HarshitJazz123/VibeSense/docs/images/dashboard pic 1.png

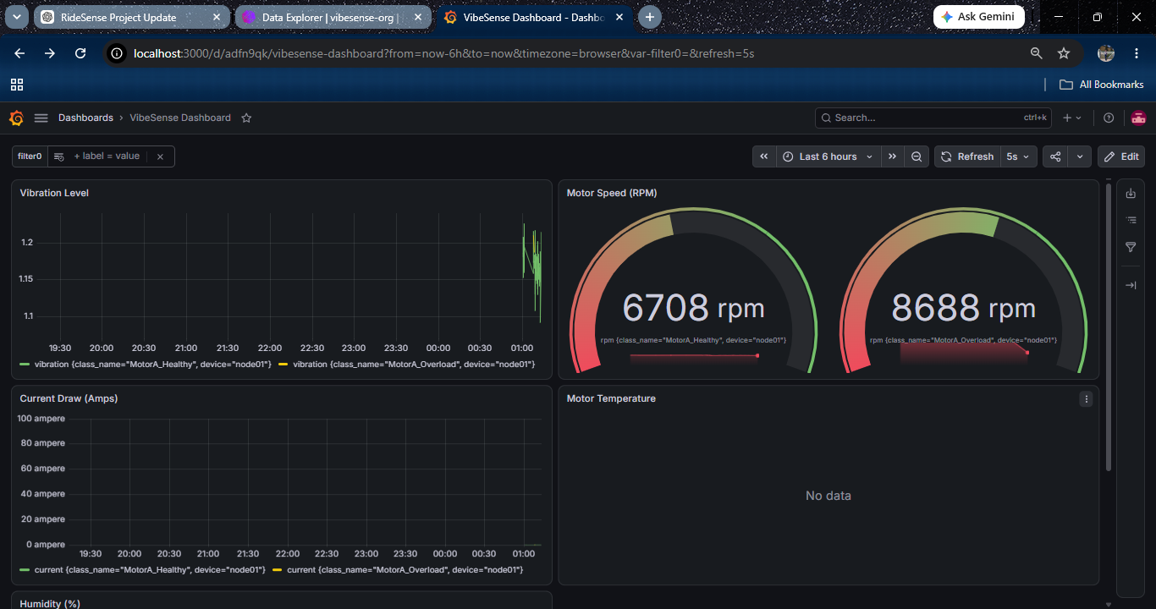
docs/images/dashboard pic 1.png
