HarshitJazz123/VibeSense/docs/images/dashboard pic 3.jpeg

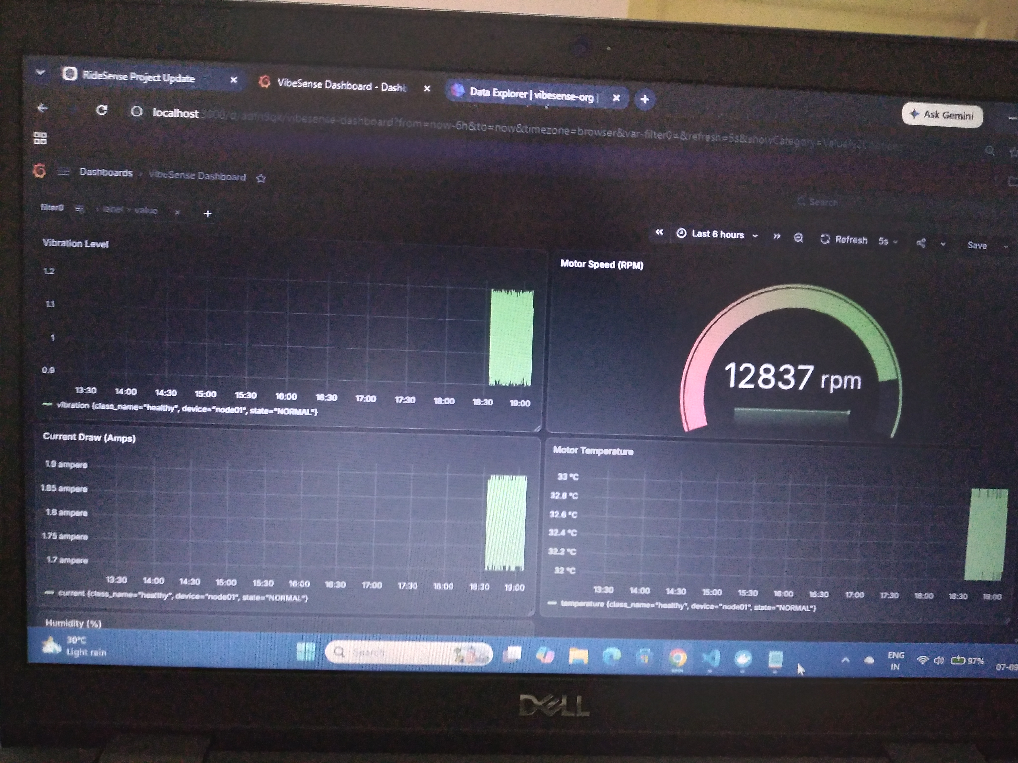
docs/images/dashboard pic 3.jpeg
