HarshitJazz123/VibeSense/docs/images/influx_telemetry.png

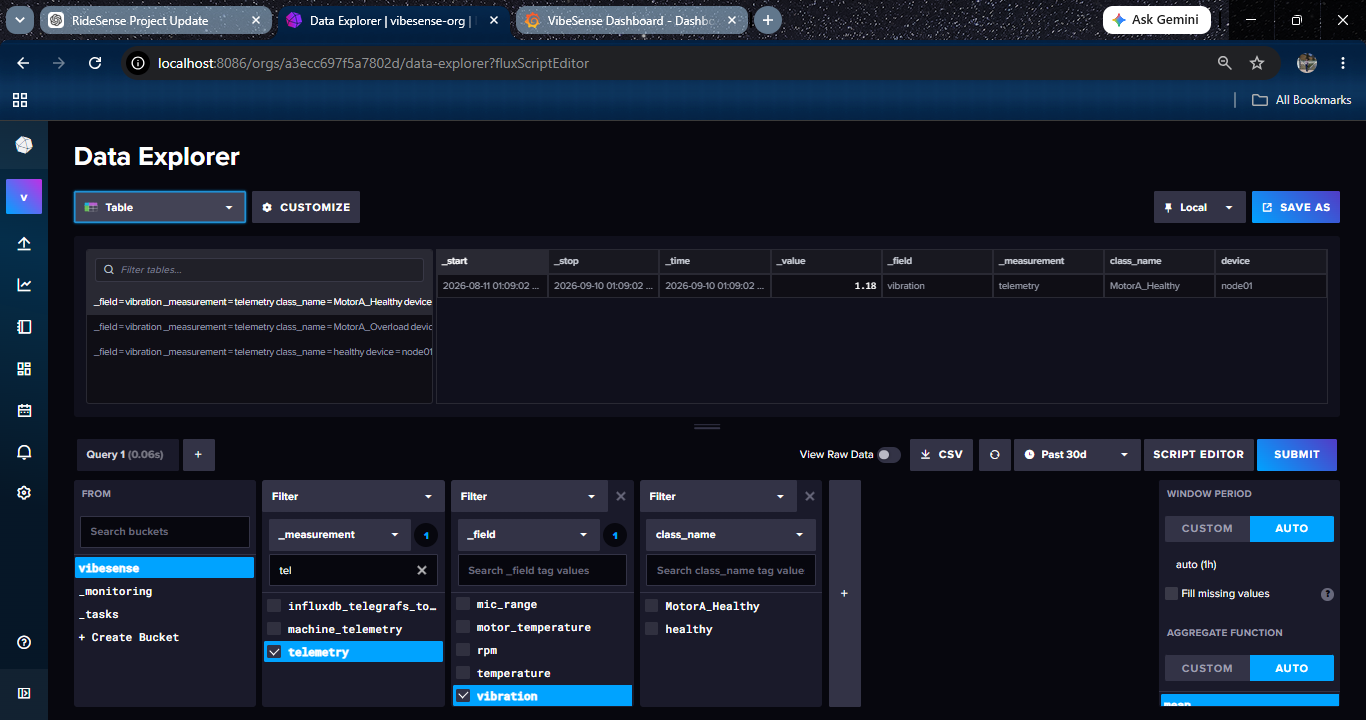
docs/images/influx_telemetry.png
