HarshitJazz123/VibeSense/sensors/secrets.example.h

const char* ssid = "YOUR_WIFI_NAME";
const char* password_wifi = "YOUR_WIFI_PASSWORD";

const char* mqtt_server = "your-cluster.s1.eu.hivemq.cloud";
const int mqtt_port = 8883;
const char* mqtt_user = "YOUR_MQTT_USER";
const char* mqtt_pass = "YOUR_MQTT_PASSWORD";
